NadeemDin/physical-ai-from-scratch/docs/images/rig-front.jpg

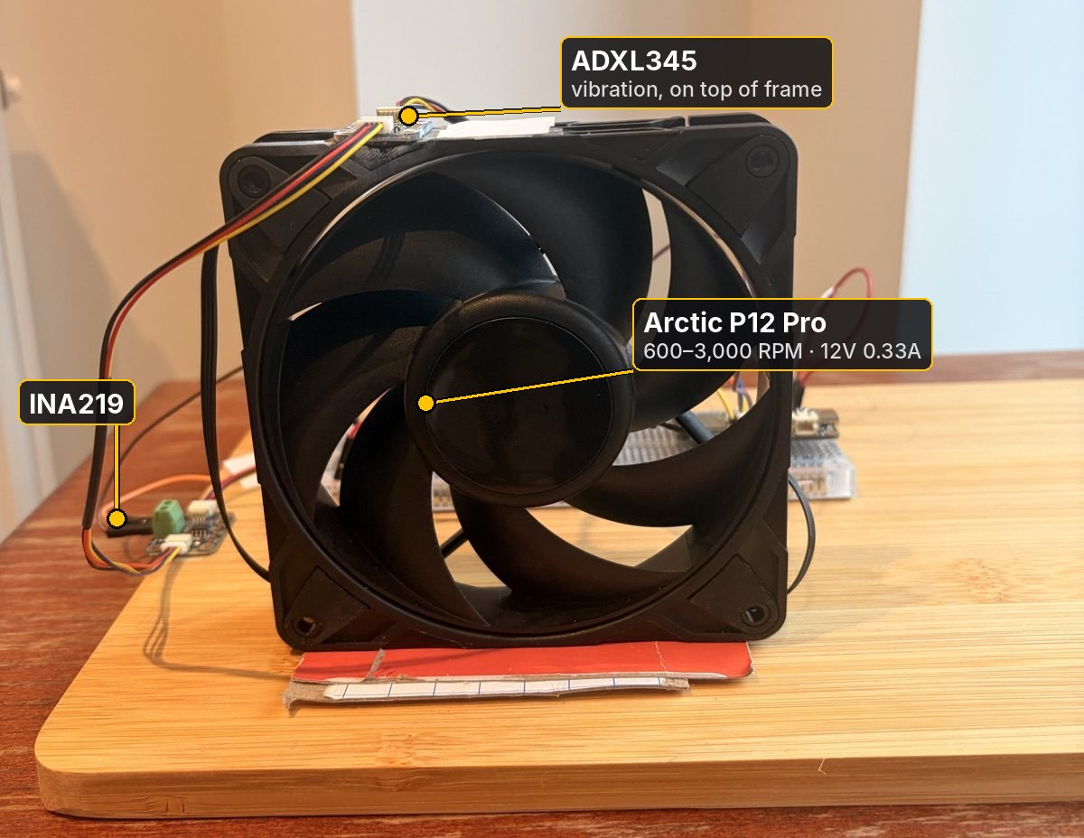
docs/images/rig-front.jpg
