NadeemDin/physical-ai-from-scratch/firmware/mqtt_test/secrets_example.h

// Copy this file to secrets.h and fill in your details.
// secrets.h is in .gitignore, so it never gets committed.
#define WIFI_SSID     "your-wifi-name"
#define WIFI_PASSWORD "your-wifi-password"
#define MQTT_HOST     "192.168.x.x"   // the computer running the broker (Docker)
#define MQTT_PORT     1883
