NadeemDin/physical-ai-from-scratch/(commit log)

2026-11-05 Add hardware doc: parts, wiring, sensor placement and results
2026-11-05 Fix: sketch name corrected and Links in build.md.
    [i2c_scan.ino]
2026-11-06 Added: rig_mqtt all sensors as JSON over MQTT
2026-11-11 Add decisions on sensor nulls, fan units and data quality
2026-11-12 Keep exact raw bytes for rejected messages; build inserts from column lists
2026-11-13 Replace prints with logging: levels, timestamps, LOG_LEVEL setting
2026-11-13 Handle database down at startup; take ts on arrival; write phase 1 section 4
    - Start in the outage state if the first database connection fails, instead of crashing
    - Take the arrival timestamp at the start of on_message, before any reconnect or query
    - Update the docstring for the startup outage case
    - phase-1.md: write section 4 (ingest service) with flow diagrams; add milestones
    - decisions.md: add 'validate at the boundary' and 'start in the outage state'; update the timestamp decision
    - build-log.md: add phase 1 entries 16-19
